KasperHesse/bachelors-project/(commit log)

2021-03-04 Added fixed-point arithmeti circuits
2021-03-04 Bucketload of scala tests
2021-03-19 Added first batch of pipeline stages
2021-03-19 More comments in top.c, added KE-values
    [ke-fixed.csv, ke-standard.csv]
2021-03-22 Rename instructions and opcode, add decode/execute stage
2021-04-09 Updated decoder, added threads
2021-04-09 Initial version of Assembler
2021-04-09 Add GTKwave enum filter files
2021-05-07 Renamed a couple of methods and parameters
2021-05-07 Added assembler functionality + tests, only missing Stype now
2021-05-17 Initial commit of memory stage stuff
2021-05-17 Update assembler to support ABS
2021-05-17 Rewrote top.c in assembly
2021-05-19 Update Thread.scala to map vRegFile to on-chip memory
2021-05-19 Decode stage now resets memthread/execthread handles on new packets
2021-05-20 Update memory stage files
2021-05-20 Added test files for memore stage
2021-05-20 Updated memory interface for decode and thread
2021-05-20 Added file writing method to assembler
2021-05-24 Slight modifications to Thread, added extra config checks
2021-05-28 All memory stage loads now work as expected
2021-05-31 Thread memory access module finished
2021-05-31 Start work on combining thread+memory. Re-added tests
2021-06-01 Decode stage + memory implemented, works as expected
2021-06-02 Memory stage now supports writes
2021-06-08 Update decode/thread to use syncreadmem sreg
    Also, modified all IP's in Decode and Thread to use variable instead of fixed bitwidth
2021-06-13 Update immediate logic and thread IP bitwidth
2021-06-13 Update PE's to use multicycle div, threads use multiple membanks
2021-06-17 Start assembly rewrite
2021-06-17 Update GTKwave filters
2021-06-21 Update KE to use correct values
    [ke.csv]
2021-06-22 Clean up control stage
2021-09-20 Fixed RED-instructions, added functions to assembler
2021-10-26 Added memory dump comparison, load
    Can now compare memory dumps generated by C-code and Scala. Can also load in previous memdumps, making it easier to test the entire program
    [memdump_DV.csv, memdump_F.csv]
2021-11-09 Lots of changes, updated test infrastructure
    [memdump_DV.csv, memdump_F.csv]
2022-01-04 Modify programs
    [ke-mapped.csv]
2022-01-07 Finalize KE-transform script, CG loop converges!
    [ke-0.csv, ke-1.csv, ke-2.csv, ke-3.csv, ke-4.csv, ke-5.csv, ke-6.csv, ke-7.csv]
2022-01-15 Add remaining UART files
2022-01-16 Finalized UART transmitter, working
2022-01-18 Updated version of TopLevel, working on a 6x6x6 grid
    [uart_parsed.csv]
2022-01-18 Add 10x10x10 program, additional data transmitted over uart
